keshavgupta21/6.115-final/PSoCCreator/Final Project/ComponentUpdateLog.txt

Last Modified Date & Time: 05/02/2019 18:38:56
