keshavgupta21/6.115-final/Final Report/debounce_fsm.png

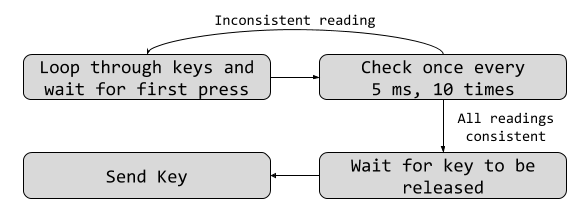
Final Report/debounce_fsm.png
