keshavgupta21/6.115-final/Final Report/spi_datasheet.png

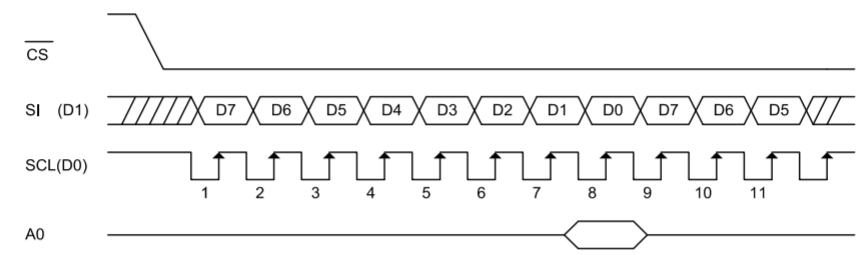
Final Report/spi_datasheet.png
