keshavgupta21/6.115-final/Proposal Draft/hardware.png

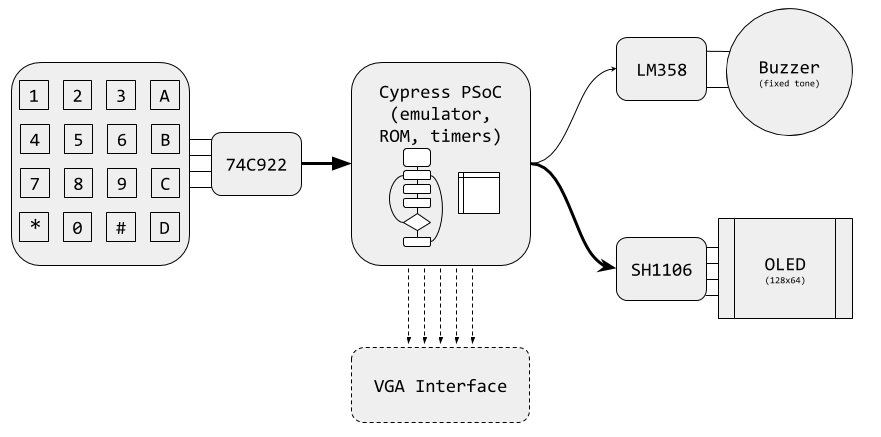
Proposal Draft/hardware.png
