keshavgupta21/6.115-final/Proposal Draft/software.png

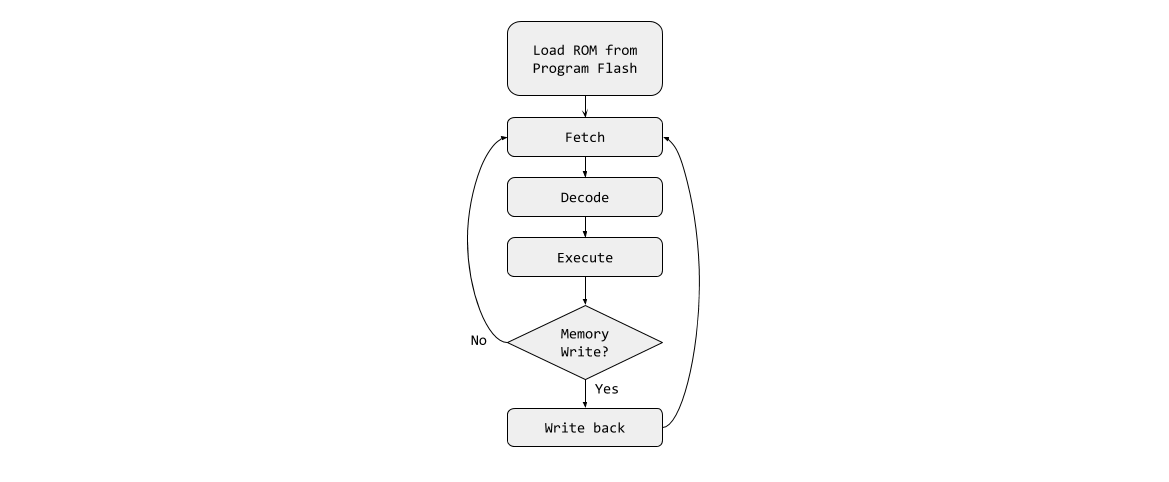
Proposal Draft/software.png
