keshavgupta21/6.115-final/(list of files, cad)

Other CAD files:
case/box.dwg
