keshavgupta21/6.115-final/PSoCCreator/Final Project/FinalEmulator.cydsn/CortexM3/ARM_GCC_541/Debug/LINK_options.txt

-Wl,--start-group -o "C:\\Users\\info\\Desktop\\Spring\ 2019\ Classes\\6.115\\6.115-final\\PSoCCreator\\Final\ Project\\FinalEmulator.cydsn\\CortexM3\\ARM_GCC_541\\Debug\\FinalEmulator.elf" ".\\CortexM3\\ARM_GCC_541\\Debug\\u8g2_bitmap.o" ".\\CortexM3\\ARM_GCC_541\\Debug\\u8g2_box.o" ".\\CortexM3\\ARM_GCC_541\\Debug\\u8g2_buffer.o" ".\\CortexM3\\ARM_GCC_541\\Debug\\u8g2_circle.o" ".\\CortexM3\\ARM_GCC_541\\Debug\\u8g2_cleardisplay.o" ".\\CortexM3\\ARM_GCC_541\\Debug\\u8g2_d_memory.o" ".\\CortexM3\\ARM_GCC_541\\Debug\\u8g2_d_setup.o" ".\\CortexM3\\ARM_GCC_541\\Debug\\u8g2_font.o" ".\\CortexM3\\ARM_GCC_541\\Debug\\u8g2_fonts.o" ".\\CortexM3\\ARM_GCC_541\\Debug\\u8g2_hvline.o" ".\\CortexM3\\ARM_GCC_541\\Debug\\u8g2_input_value.o" ".\\CortexM3\\ARM_GCC_541\\Debug\\u8g2_intersection.o" ".\\CortexM3\\ARM_GCC_541\\Debug\\u8g2_kerning.o" ".\\CortexM3\\ARM_GCC_541\\Debug\\u8g2_line.o" ".\\CortexM3\\ARM_GCC_541\\Debug\\u8g2_ll_hvline.o" ".\\CortexM3\\ARM_GCC_541\\Debug\\u8g2_message.o" ".\\CortexM3\\ARM_GCC_541\\Debug\\u8g2_polygon.o" ".\\CortexM3\\ARM_GCC_541\\Debug\\u8g2_selection_list.o" ".\\CortexM3\\ARM_GCC_541\\Debug\\u8g2_setup.o" ".\\CortexM3\\ARM_GCC_541\\Debug\\u8log.o" ".\\CortexM3\\ARM_GCC_541\\Debug\\u8log_u8g2.o" ".\\CortexM3\\ARM_GCC_541\\Debug\\u8log_u8x8.o" ".\\CortexM3\\ARM_GCC_541\\Debug\\u8x8_8x8.o" ".\\CortexM3\\ARM_GCC_541\\Debug\\u8x8_byte.o" ".\\CortexM3\\ARM_GCC_541\\Debug\\u8x8_cad.o" ".\\CortexM3\\ARM_GCC_541\\Debug\\u8x8_d_a2printer.o" ".\\CortexM3\\ARM_GCC_541\\Debug\\u8x8_d_il3820_296x128.o" ".\\CortexM3\\ARM_GCC_541\\Debug\\u8x8_d_ist3020.o" ".\\CortexM3\\ARM_GCC_541\\Debug\\u8x8_d_ks0108.o" ".\\CortexM3\\ARM_GCC_541\\Debug\\u8x8_d_lc7981.o" ".\\CortexM3\\ARM_GCC_541\\Debug\\u8x8_d_ld7032_60x32.o" ".\\CortexM3\\ARM_GCC_541\\Debug\\u8x8_d_ls013b7dh03.o" ".\\CortexM3\\ARM_GCC_541\\Debug\\u8x8_d_max7219.o" ".\\CortexM3\\ARM_GCC_541\\Debug\\u8x8_d_pcd8544_84x48.o" ".\\CortexM3\\ARM_GCC_541\\Debug\\u8x8_d_pcf8812.o" ".\\CortexM3\\ARM_GCC_541\\Debug\\u8x8_d_pcf8814_hx1230.o" ".\\CortexM3\\ARM_GCC_541\\Debug\\u8x8_d_sbn1661.o" ".\\CortexM3\\ARM_GCC_541\\Debug\\u8x8_d_sed1330.o" ".\\CortexM3\\ARM_GCC_541\\Debug\\u8x8_d_sh1106_64x32.o" ".\\CortexM3\\ARM_GCC_541\\Debug\\u8x8_d_sh1106_72x40.o" ".\\CortexM3\\ARM_GCC_541\\Debug\\u8x8_d_sh1107.o" ".\\CortexM3\\ARM_GCC_541\\Debug\\u8x8_d_sh1108.o" ".\\CortexM3\\ARM_GCC_541\\Debug\\u8x8_d_sh1122.o" ".\\CortexM3\\ARM_GCC_541\\Debug\\u8x8_d_ssd1305.o" ".\\CortexM3\\ARM_GCC_541\\Debug\\u8x8_d_ssd1306_48x64.o" ".\\CortexM3\\ARM_GCC_541\\Debug\\u8x8_d_ssd1306_64x32.o" ".\\CortexM3\\ARM_GCC_541\\Debug\\u8x8_d_ssd1306_64x48.o" ".\\CortexM3\\ARM_GCC_541\\Debug\\u8x8_d_ssd1306_96x16.o" ".\\CortexM3\\ARM_GCC_541\\Debug\\u8x8_d_ssd1306_128x32.o" ".\\CortexM3\\ARM_GCC_541\\Debug\\u8x8_d_ssd1306_128x64_noname.o" ".\\CortexM3\\ARM_GCC_541\\Debug\\u8x8_d_ssd1309.o" ".\\CortexM3\\ARM_GCC_541\\Debug\\u8x8_d_ssd1317.o" ".\\CortexM3\\ARM_GCC_541\\Debug\\u8x8_d_ssd1318.o" ".\\CortexM3\\ARM_GCC_541\\Debug\\u8x8_d_ssd1322.o" ".\\CortexM3\\ARM_GCC_541\\Debug\\u8x8_d_ssd1325.o" ".\\CortexM3\\ARM_GCC_541\\Debug\\u8x8_d_ssd1326.o" ".\\CortexM3\\ARM_GCC_541\\Debug\\u8x8_d_ssd1327.o" ".\\CortexM3\\ARM_GCC_541\\Debug\\u8x8_d_ssd1329.o" ".\\CortexM3\\ARM_GCC_541\\Debug\\u8x8_d_ssd1606_172x72.o" ".\\CortexM3\\ARM_GCC_541\\Debug\\u8x8_d_ssd1607_200x200.o" ".\\CortexM3\\ARM_GCC_541\\Debug\\u8x8_d_st7511.o" ".\\CortexM3\\ARM_GCC_541\\Debug\\u8x8_d_st7565.o" ".\\CortexM3\\ARM_GCC_541\\Debug\\u8x8_d_st7567.o" ".\\CortexM3\\ARM_GCC_541\\Debug\\u8x8_d_st7586s_erc240160.o" ".\\CortexM3\\ARM_GCC_541\\Debug\\u8x8_d_st7586s_s028hn118a.o" ".\\CortexM3\\ARM_GCC_541\\Debug\\u8x8_d_st7588.o" ".\\CortexM3\\ARM_GCC_541\\Debug\\u8x8_d_st7920.o" ".\\CortexM3\\ARM_GCC_541\\Debug\\u8x8_d_st75256.o" ".\\CortexM3\\ARM_GCC_541\\Debug\\u8x8_d_stdio.o" ".\\CortexM3\\ARM_GCC_541\\Debug\\u8x8_d_t6963.o" ".\\CortexM3\\ARM_GCC_541\\Debug\\u8x8_d_uc1601.o" ".\\CortexM3\\ARM_GCC_541\\Debug\\u8x8_d_uc1604.o" ".\\CortexM3\\ARM_GCC_541\\Debug\\u8x8_d_uc1608.o" ".\\CortexM3\\ARM_GCC_541\\Debug\\u8x8_d_uc1610.o" ".\\CortexM3\\ARM_GCC_541\\Debug\\u8x8_d_uc1611.o" ".\\CortexM3\\ARM_GCC_541\\Debug\\u8x8_d_uc1617.o" ".\\CortexM3\\ARM_GCC_541\\Debug\\u8x8_d_uc1638.o" ".\\CortexM3\\ARM_GCC_541\\Debug\\u8x8_d_uc1701_dogs102.o" ".\\CortexM3\\ARM_GCC_541\\Debug\\u8x8_d_uc1701_mini12864.o" ".\\CortexM3\\ARM_GCC_541\\Debug\\u8x8_debounce.o" ".\\CortexM3\\ARM_GCC_541\\Debug\\u8x8_display.o" ".\\CortexM3\\ARM_GCC_541\\Debug\\u8x8_fonts.o" ".\\CortexM3\\ARM_GCC_541\\Debug\\u8x8_gpio.o" ".\\CortexM3\\ARM_GCC_541\\Debug\\u8x8_input_value.o" ".\\CortexM3\\ARM_GCC_541\\Debug\\u8x8_message.o" ".\\CortexM3\\ARM_GCC_541\\Debug\\u8x8_selection_list.o" ".\\CortexM3\\ARM_GCC_541\\Debug\\u8x8_setup.o" ".\\CortexM3\\ARM_GCC_541\\Debug\\u8x8_string.o" ".\\CortexM3\\ARM_GCC_541\\Debug\\u8x8_u8toa.o" ".\\CortexM3\\ARM_GCC_541\\Debug\\u8x8_u16toa.o" ".\\CortexM3\\ARM_GCC_541\\Debug\\main.o" ".\\CortexM3\\ARM_GCC_541\\Debug\\procr.o" ".\\CortexM3\\ARM_GCC_541\\Debug\\video.o" ".\\CortexM3\\ARM_GCC_541\\Debug\\timer.o" ".\\CortexM3\\ARM_GCC_541\\Debug\\keybd.o" ".\\CortexM3\\ARM_GCC_541\\Debug\\oled.o" ".\\CortexM3\\ARM_GCC_541\\Debug\\uart.o" ".\\CortexM3\\ARM_GCC_541\\Debug\\cyfitter_cfg.o" ".\\CortexM3\\ARM_GCC_541\\Debug\\cymetadata.o" ".\\CortexM3\\ARM_GCC_541\\Debug\\Cm3Start.o" ".\\CortexM3\\ARM_GCC_541\\Debug\\FinalEmulator.a" "C:\\Program\ Files\ (x86)\\Cypress\\PSoC\ Creator\\4.2\\PSoC\ Creator\\psoc\\content\\cycomponentlibrary\\CyComponentLibrary.cylib\\CortexM3\\ARM_GCC_541\\Debug\\CyComponentLibrary.a" -mcpu=cortex-m3 -mthumb -L "Generated_Source\\PSoC5" "-Wl,-Map,.\\CortexM3\\ARM_GCC_541\\Debug/FinalEmulator.map" -T ".\\custom.ld" -specs=nano.specs -Wl,--gc-sections -g -ffunction-sections -Og -flto -ffat-lto-objects -Wl,--end-group
