keshavgupta21/6.115-final/PSoCCreator/Final Project/FinalEmulator.cydsn/codegentemp/pin_oled_dc.h

/*******************************************************************************
* File Name: pin_oled_dc.h  
* Version 2.20
*
* Description:
*  This file contains Pin function prototypes and register defines
*
* Note:
*
********************************************************************************
* Copyright 2008-2015, Cypress Semiconductor Corporation.  All rights reserved.
* You may use this file only in accordance with the license, terms, conditions, 
* disclaimers, and limitations in the end user license agreement accompanying 
* the software package with which this file was provided.
*******************************************************************************/

#if !defined(CY_PINS_pin_oled_dc_H) /* Pins pin_oled_dc_H */
#define CY_PINS_pin_oled_dc_H

#include "cytypes.h"
#include "cyfitter.h"
#include "cypins.h"
#include "pin_oled_dc_aliases.h"

/* APIs are not generated for P15[7:6] */
#if !(CY_PSOC5A &&\
	 pin_oled_dc__PORT == 15 && ((pin_oled_dc__MASK & 0xC0) != 0))


/***************************************
*        Function Prototypes             
***************************************/    

/**
* \addtogroup group_general
* @{
*/
void    pin_oled_dc_Write(uint8 value);
void    pin_oled_dc_SetDriveMode(uint8 mode);
uint8   pin_oled_dc_ReadDataReg(void);
uint8   pin_oled_dc_Read(void);
void    pin_oled_dc_SetInterruptMode(uint16 position, uint16 mode);
uint8   pin_oled_dc_ClearInterrupt(void);
/** @} general */

/***************************************
*           API Constants        
***************************************/
/**
* \addtogroup group_constants
* @{
*/
    /** \addtogroup driveMode Drive mode constants
     * \brief Constants to be passed as "mode" parameter in the pin_oled_dc_SetDriveMode() function.
     *  @{
     */
        #define pin_oled_dc_DM_ALG_HIZ         PIN_DM_ALG_HIZ
        #define pin_oled_dc_DM_DIG_HIZ         PIN_DM_DIG_HIZ
        #define pin_oled_dc_DM_RES_UP          PIN_DM_RES_UP
        #define pin_oled_dc_DM_RES_DWN         PIN_DM_RES_DWN
        #define pin_oled_dc_DM_OD_LO           PIN_DM_OD_LO
        #define pin_oled_dc_DM_OD_HI           PIN_DM_OD_HI
        #define pin_oled_dc_DM_STRONG          PIN_DM_STRONG
        #define pin_oled_dc_DM_RES_UPDWN       PIN_DM_RES_UPDWN
    /** @} driveMode */
/** @} group_constants */
    
/* Digital Port Constants */
#define pin_oled_dc_MASK               pin_oled_dc__MASK
#define pin_oled_dc_SHIFT              pin_oled_dc__SHIFT
#define pin_oled_dc_WIDTH              1u

/* Interrupt constants */
#if defined(pin_oled_dc__INTSTAT)
/**
* \addtogroup group_constants
* @{
*/
    /** \addtogroup intrMode Interrupt constants
     * \brief Constants to be passed as "mode" parameter in pin_oled_dc_SetInterruptMode() function.
     *  @{
     */
        #define pin_oled_dc_INTR_NONE      (uint16)(0x0000u)
        #define pin_oled_dc_INTR_RISING    (uint16)(0x0001u)
        #define pin_oled_dc_INTR_FALLING   (uint16)(0x0002u)
        #define pin_oled_dc_INTR_BOTH      (uint16)(0x0003u) 
    /** @} intrMode */
/** @} group_constants */

    #define pin_oled_dc_INTR_MASK      (0x01u) 
#endif /* (pin_oled_dc__INTSTAT) */


/***************************************
*             Registers        
***************************************/

/* Main Port Registers */
/* Pin State */
#define pin_oled_dc_PS                     (* (reg8 *) pin_oled_dc__PS)
/* Data Register */
#define pin_oled_dc_DR                     (* (reg8 *) pin_oled_dc__DR)
/* Port Number */
#define pin_oled_dc_PRT_NUM                (* (reg8 *) pin_oled_dc__PRT) 
/* Connect to Analog Globals */                                                  
#define pin_oled_dc_AG                     (* (reg8 *) pin_oled_dc__AG)                       
/* Analog MUX bux enable */
#define pin_oled_dc_AMUX                   (* (reg8 *) pin_oled_dc__AMUX) 
/* Bidirectional Enable */                                                        
#define pin_oled_dc_BIE                    (* (reg8 *) pin_oled_dc__BIE)
/* Bit-mask for Aliased Register Access */
#define pin_oled_dc_BIT_MASK               (* (reg8 *) pin_oled_dc__BIT_MASK)
/* Bypass Enable */
#define pin_oled_dc_BYP                    (* (reg8 *) pin_oled_dc__BYP)
/* Port wide control signals */                                                   
#define pin_oled_dc_CTL                    (* (reg8 *) pin_oled_dc__CTL)
/* Drive Modes */
#define pin_oled_dc_DM0                    (* (reg8 *) pin_oled_dc__DM0) 
#define pin_oled_dc_DM1                    (* (reg8 *) pin_oled_dc__DM1)
#define pin_oled_dc_DM2                    (* (reg8 *) pin_oled_dc__DM2) 
/* Input Buffer Disable Override */
#define pin_oled_dc_INP_DIS                (* (reg8 *) pin_oled_dc__INP_DIS)
/* LCD Common or Segment Drive */
#define pin_oled_dc_LCD_COM_SEG            (* (reg8 *) pin_oled_dc__LCD_COM_SEG)
/* Enable Segment LCD */
#define pin_oled_dc_LCD_EN                 (* (reg8 *) pin_oled_dc__LCD_EN)
/* Slew Rate Control */
#define pin_oled_dc_SLW                    (* (reg8 *) pin_oled_dc__SLW)

/* DSI Port Registers */
/* Global DSI Select Register */
#define pin_oled_dc_PRTDSI__CAPS_SEL       (* (reg8 *) pin_oled_dc__PRTDSI__CAPS_SEL) 
/* Double Sync Enable */
#define pin_oled_dc_PRTDSI__DBL_SYNC_IN    (* (reg8 *) pin_oled_dc__PRTDSI__DBL_SYNC_IN) 
/* Output Enable Select Drive Strength */
#define pin_oled_dc_PRTDSI__OE_SEL0        (* (reg8 *) pin_oled_dc__PRTDSI__OE_SEL0) 
#define pin_oled_dc_PRTDSI__OE_SEL1        (* (reg8 *) pin_oled_dc__PRTDSI__OE_SEL1) 
/* Port Pin Output Select Registers */
#define pin_oled_dc_PRTDSI__OUT_SEL0       (* (reg8 *) pin_oled_dc__PRTDSI__OUT_SEL0) 
#define pin_oled_dc_PRTDSI__OUT_SEL1       (* (reg8 *) pin_oled_dc__PRTDSI__OUT_SEL1) 
/* Sync Output Enable Registers */
#define pin_oled_dc_PRTDSI__SYNC_OUT       (* (reg8 *) pin_oled_dc__PRTDSI__SYNC_OUT) 

/* SIO registers */
#if defined(pin_oled_dc__SIO_CFG)
    #define pin_oled_dc_SIO_HYST_EN        (* (reg8 *) pin_oled_dc__SIO_HYST_EN)
    #define pin_oled_dc_SIO_REG_HIFREQ     (* (reg8 *) pin_oled_dc__SIO_REG_HIFREQ)
    #define pin_oled_dc_SIO_CFG            (* (reg8 *) pin_oled_dc__SIO_CFG)
    #define pin_oled_dc_SIO_DIFF           (* (reg8 *) pin_oled_dc__SIO_DIFF)
#endif /* (pin_oled_dc__SIO_CFG) */

/* Interrupt Registers */
#if defined(pin_oled_dc__INTSTAT)
    #define pin_oled_dc_INTSTAT            (* (reg8 *) pin_oled_dc__INTSTAT)
    #define pin_oled_dc_SNAP               (* (reg8 *) pin_oled_dc__SNAP)
    
	#define pin_oled_dc_0_INTTYPE_REG 		(* (reg8 *) pin_oled_dc__0__INTTYPE)
#endif /* (pin_oled_dc__INTSTAT) */

#endif /* CY_PSOC5A... */

#endif /*  CY_PINS_pin_oled_dc_H */


/* [] END OF FILE */
