keshavgupta21/6.115-final/PSoCCreator/Final Project/FinalEmulator.cydsn/codegentemp/pwm_snd.h

/*******************************************************************************
* File Name: pwm_snd.h
* Version 3.30
*
* Description:
*  Contains the prototypes and constants for the functions available to the
*  PWM user module.
*
* Note:
*
********************************************************************************
* Copyright 2008-2014, Cypress Semiconductor Corporation.  All rights reserved.
* You may use this file only in accordance with the license, terms, conditions,
* disclaimers, and limitations in the end user license agreement accompanying
* the software package with which this file was provided.
********************************************************************************/

#if !defined(CY_PWM_pwm_snd_H)
#define CY_PWM_pwm_snd_H

#include "cyfitter.h"
#include "cytypes.h"
#include "CyLib.h" /* For CyEnterCriticalSection() and CyExitCriticalSection() functions */

extern uint8 pwm_snd_initVar;


/***************************************
* Conditional Compilation Parameters
***************************************/
#define pwm_snd_Resolution                     (8u)
#define pwm_snd_UsingFixedFunction             (0u)
#define pwm_snd_DeadBandMode                   (0u)
#define pwm_snd_KillModeMinTime                (0u)
#define pwm_snd_KillMode                       (0u)
#define pwm_snd_PWMMode                        (0u)
#define pwm_snd_PWMModeIsCenterAligned         (0u)
#define pwm_snd_DeadBandUsed                   (0u)
#define pwm_snd_DeadBand2_4                    (0u)

#if !defined(pwm_snd_PWMUDB_genblk8_stsreg__REMOVED)
    #define pwm_snd_UseStatus                  (1u)
#else
    #define pwm_snd_UseStatus                  (0u)
#endif /* !defined(pwm_snd_PWMUDB_genblk8_stsreg__REMOVED) */

#if !defined(pwm_snd_PWMUDB_genblk1_ctrlreg__REMOVED)
    #define pwm_snd_UseControl                 (1u)
#else
    #define pwm_snd_UseControl                 (0u)
#endif /* !defined(pwm_snd_PWMUDB_genblk1_ctrlreg__REMOVED) */

#define pwm_snd_UseOneCompareMode              (1u)
#define pwm_snd_MinimumKillTime                (1u)
#define pwm_snd_EnableMode                     (0u)

#define pwm_snd_CompareMode1SW                 (0u)
#define pwm_snd_CompareMode2SW                 (0u)

/* Check to see if required defines such as CY_PSOC5LP are available */
/* They are defined starting with cy_boot v3.0 */
#if !defined (CY_PSOC5LP)
    #error Component PWM_v3_30 requires cy_boot v3.0 or later
#endif /* (CY_ PSOC5LP) */

/* Use Kill Mode Enumerated Types */
#define pwm_snd__B_PWM__DISABLED 0
#define pwm_snd__B_PWM__ASYNCHRONOUS 1
#define pwm_snd__B_PWM__SINGLECYCLE 2
#define pwm_snd__B_PWM__LATCHED 3
#define pwm_snd__B_PWM__MINTIME 4


/* Use Dead Band Mode Enumerated Types */
#define pwm_snd__B_PWM__DBMDISABLED 0
#define pwm_snd__B_PWM__DBM_2_4_CLOCKS 1
#define pwm_snd__B_PWM__DBM_256_CLOCKS 2


/* Used PWM Mode Enumerated Types */
#define pwm_snd__B_PWM__ONE_OUTPUT 0
#define pwm_snd__B_PWM__TWO_OUTPUTS 1
#define pwm_snd__B_PWM__DUAL_EDGE 2
#define pwm_snd__B_PWM__CENTER_ALIGN 3
#define pwm_snd__B_PWM__DITHER 5
#define pwm_snd__B_PWM__HARDWARESELECT 4


/* Used PWM Compare Mode Enumerated Types */
#define pwm_snd__B_PWM__LESS_THAN 1
#define pwm_snd__B_PWM__LESS_THAN_OR_EQUAL 2
#define pwm_snd__B_PWM__GREATER_THAN 3
#define pwm_snd__B_PWM__GREATER_THAN_OR_EQUAL_TO 4
#define pwm_snd__B_PWM__EQUAL 0
#define pwm_snd__B_PWM__FIRMWARE 5



/***************************************
* Data Struct Definition
***************************************/


/**************************************************************************
 * Sleep Wakeup Backup structure for PWM Component
 *************************************************************************/
typedef struct
{

    uint8 PWMEnableState;

    #if(!pwm_snd_UsingFixedFunction)
        uint8 PWMUdb;               /* PWM Current Counter value  */
        #if(!pwm_snd_PWMModeIsCenterAligned)
            uint8 PWMPeriod;
        #endif /* (!pwm_snd_PWMModeIsCenterAligned) */
        #if (pwm_snd_UseStatus)
            uint8 InterruptMaskValue;   /* PWM Current Interrupt Mask */
        #endif /* (pwm_snd_UseStatus) */

        /* Backup for Deadband parameters */
        #if(pwm_snd_DeadBandMode == pwm_snd__B_PWM__DBM_256_CLOCKS || \
            pwm_snd_DeadBandMode == pwm_snd__B_PWM__DBM_2_4_CLOCKS)
            uint8 PWMdeadBandValue; /* Dead Band Counter Current Value */
        #endif /* deadband count is either 2-4 clocks or 256 clocks */

        /* Backup Kill Mode Counter*/
        #if(pwm_snd_KillModeMinTime)
            uint8 PWMKillCounterPeriod; /* Kill Mode period value */
        #endif /* (pwm_snd_KillModeMinTime) */

        /* Backup control register */
        #if(pwm_snd_UseControl)
            uint8 PWMControlRegister; /* PWM Control Register value */
        #endif /* (pwm_snd_UseControl) */

    #endif /* (!pwm_snd_UsingFixedFunction) */

}pwm_snd_backupStruct;


/***************************************
*        Function Prototypes
 **************************************/

void    pwm_snd_Start(void) ;
void    pwm_snd_Stop(void) ;

#if (pwm_snd_UseStatus || pwm_snd_UsingFixedFunction)
    void  pwm_snd_SetInterruptMode(uint8 interruptMode) ;
    uint8 pwm_snd_ReadStatusRegister(void) ;
#endif /* (pwm_snd_UseStatus || pwm_snd_UsingFixedFunction) */

#define pwm_snd_GetInterruptSource() pwm_snd_ReadStatusRegister()

#if (pwm_snd_UseControl)
    uint8 pwm_snd_ReadControlRegister(void) ;
    void  pwm_snd_WriteControlRegister(uint8 control)
          ;
#endif /* (pwm_snd_UseControl) */

#if (pwm_snd_UseOneCompareMode)
   #if (pwm_snd_CompareMode1SW)
       void    pwm_snd_SetCompareMode(uint8 comparemode)
               ;
   #endif /* (pwm_snd_CompareMode1SW) */
#else
    #if (pwm_snd_CompareMode1SW)
        void    pwm_snd_SetCompareMode1(uint8 comparemode)
                ;
    #endif /* (pwm_snd_CompareMode1SW) */
    #if (pwm_snd_CompareMode2SW)
        void    pwm_snd_SetCompareMode2(uint8 comparemode)
                ;
    #endif /* (pwm_snd_CompareMode2SW) */
#endif /* (pwm_snd_UseOneCompareMode) */

#if (!pwm_snd_UsingFixedFunction)
    uint8   pwm_snd_ReadCounter(void) ;
    uint8 pwm_snd_ReadCapture(void) ;

    #if (pwm_snd_UseStatus)
            void pwm_snd_ClearFIFO(void) ;
    #endif /* (pwm_snd_UseStatus) */

    void    pwm_snd_WriteCounter(uint8 counter)
            ;
#endif /* (!pwm_snd_UsingFixedFunction) */

void    pwm_snd_WritePeriod(uint8 period)
        ;
uint8 pwm_snd_ReadPeriod(void) ;

#if (pwm_snd_UseOneCompareMode)
    void    pwm_snd_WriteCompare(uint8 compare)
            ;
    uint8 pwm_snd_ReadCompare(void) ;
#else
    void    pwm_snd_WriteCompare1(uint8 compare)
            ;
    uint8 pwm_snd_ReadCompare1(void) ;
    void    pwm_snd_WriteCompare2(uint8 compare)
            ;
    uint8 pwm_snd_ReadCompare2(void) ;
#endif /* (pwm_snd_UseOneCompareMode) */


#if (pwm_snd_DeadBandUsed)
    void    pwm_snd_WriteDeadTime(uint8 deadtime) ;
    uint8   pwm_snd_ReadDeadTime(void) ;
#endif /* (pwm_snd_DeadBandUsed) */

#if ( pwm_snd_KillModeMinTime)
    void pwm_snd_WriteKillTime(uint8 killtime) ;
    uint8 pwm_snd_ReadKillTime(void) ;
#endif /* ( pwm_snd_KillModeMinTime) */

void pwm_snd_Init(void) ;
void pwm_snd_Enable(void) ;
void pwm_snd_Sleep(void) ;
void pwm_snd_Wakeup(void) ;
void pwm_snd_SaveConfig(void) ;
void pwm_snd_RestoreConfig(void) ;


/***************************************
*         Initialization Values
**************************************/
#define pwm_snd_INIT_PERIOD_VALUE          (1u)
#define pwm_snd_INIT_COMPARE_VALUE1        (0u)
#define pwm_snd_INIT_COMPARE_VALUE2        (128u)
#define pwm_snd_INIT_INTERRUPTS_MODE       (uint8)(((uint8)(0u <<   \
                                                    pwm_snd_STATUS_TC_INT_EN_MASK_SHIFT)) | \
                                                    (uint8)((uint8)(0u <<  \
                                                    pwm_snd_STATUS_CMP2_INT_EN_MASK_SHIFT)) | \
                                                    (uint8)((uint8)(0u <<  \
                                                    pwm_snd_STATUS_CMP1_INT_EN_MASK_SHIFT )) | \
                                                    (uint8)((uint8)(0u <<  \
                                                    pwm_snd_STATUS_KILL_INT_EN_MASK_SHIFT )))
#define pwm_snd_DEFAULT_COMPARE2_MODE      (uint8)((uint8)2u <<  pwm_snd_CTRL_CMPMODE2_SHIFT)
#define pwm_snd_DEFAULT_COMPARE1_MODE      (uint8)((uint8)2u <<  pwm_snd_CTRL_CMPMODE1_SHIFT)
#define pwm_snd_INIT_DEAD_TIME             (1u)


/********************************
*         Registers
******************************** */

#if (pwm_snd_UsingFixedFunction)
   #define pwm_snd_PERIOD_LSB              (*(reg16 *) pwm_snd_PWMHW__PER0)
   #define pwm_snd_PERIOD_LSB_PTR          ( (reg16 *) pwm_snd_PWMHW__PER0)
   #define pwm_snd_COMPARE1_LSB            (*(reg16 *) pwm_snd_PWMHW__CNT_CMP0)
   #define pwm_snd_COMPARE1_LSB_PTR        ( (reg16 *) pwm_snd_PWMHW__CNT_CMP0)
   #define pwm_snd_COMPARE2_LSB            (0x00u)
   #define pwm_snd_COMPARE2_LSB_PTR        (0x00u)
   #define pwm_snd_COUNTER_LSB             (*(reg16 *) pwm_snd_PWMHW__CNT_CMP0)
   #define pwm_snd_COUNTER_LSB_PTR         ( (reg16 *) pwm_snd_PWMHW__CNT_CMP0)
   #define pwm_snd_CAPTURE_LSB             (*(reg16 *) pwm_snd_PWMHW__CAP0)
   #define pwm_snd_CAPTURE_LSB_PTR         ( (reg16 *) pwm_snd_PWMHW__CAP0)
   #define pwm_snd_RT1                     (*(reg8 *)  pwm_snd_PWMHW__RT1)
   #define pwm_snd_RT1_PTR                 ( (reg8 *)  pwm_snd_PWMHW__RT1)

#else
   #if (pwm_snd_Resolution == 8u) /* 8bit - PWM */

       #if(pwm_snd_PWMModeIsCenterAligned)
           #define pwm_snd_PERIOD_LSB      (*(reg8 *)  pwm_snd_PWMUDB_sP8_pwmdp_u0__D1_REG)
           #define pwm_snd_PERIOD_LSB_PTR  ((reg8 *)   pwm_snd_PWMUDB_sP8_pwmdp_u0__D1_REG)
       #else
           #define pwm_snd_PERIOD_LSB      (*(reg8 *)  pwm_snd_PWMUDB_sP8_pwmdp_u0__F0_REG)
           #define pwm_snd_PERIOD_LSB_PTR  ((reg8 *)   pwm_snd_PWMUDB_sP8_pwmdp_u0__F0_REG)
       #endif /* (pwm_snd_PWMModeIsCenterAligned) */

       #define pwm_snd_COMPARE1_LSB        (*(reg8 *)  pwm_snd_PWMUDB_sP8_pwmdp_u0__D0_REG)
       #define pwm_snd_COMPARE1_LSB_PTR    ((reg8 *)   pwm_snd_PWMUDB_sP8_pwmdp_u0__D0_REG)
       #define pwm_snd_COMPARE2_LSB        (*(reg8 *)  pwm_snd_PWMUDB_sP8_pwmdp_u0__D1_REG)
       #define pwm_snd_COMPARE2_LSB_PTR    ((reg8 *)   pwm_snd_PWMUDB_sP8_pwmdp_u0__D1_REG)
       #define pwm_snd_COUNTERCAP_LSB      (*(reg8 *)  pwm_snd_PWMUDB_sP8_pwmdp_u0__A1_REG)
       #define pwm_snd_COUNTERCAP_LSB_PTR  ((reg8 *)   pwm_snd_PWMUDB_sP8_pwmdp_u0__A1_REG)
       #define pwm_snd_COUNTER_LSB         (*(reg8 *)  pwm_snd_PWMUDB_sP8_pwmdp_u0__A0_REG)
       #define pwm_snd_COUNTER_LSB_PTR     ((reg8 *)   pwm_snd_PWMUDB_sP8_pwmdp_u0__A0_REG)
       #define pwm_snd_CAPTURE_LSB         (*(reg8 *)  pwm_snd_PWMUDB_sP8_pwmdp_u0__F1_REG)
       #define pwm_snd_CAPTURE_LSB_PTR     ((reg8 *)   pwm_snd_PWMUDB_sP8_pwmdp_u0__F1_REG)

   #else
        #if(CY_PSOC3) /* 8-bit address space */
            #if(pwm_snd_PWMModeIsCenterAligned)
               #define pwm_snd_PERIOD_LSB      (*(reg16 *) pwm_snd_PWMUDB_sP8_pwmdp_u0__D1_REG)
               #define pwm_snd_PERIOD_LSB_PTR  ((reg16 *)  pwm_snd_PWMUDB_sP8_pwmdp_u0__D1_REG)
            #else
               #define pwm_snd_PERIOD_LSB      (*(reg16 *) pwm_snd_PWMUDB_sP8_pwmdp_u0__F0_REG)
               #define pwm_snd_PERIOD_LSB_PTR  ((reg16 *)  pwm_snd_PWMUDB_sP8_pwmdp_u0__F0_REG)
            #endif /* (pwm_snd_PWMModeIsCenterAligned) */

            #define pwm_snd_COMPARE1_LSB       (*(reg16 *) pwm_snd_PWMUDB_sP8_pwmdp_u0__D0_REG)
            #define pwm_snd_COMPARE1_LSB_PTR   ((reg16 *)  pwm_snd_PWMUDB_sP8_pwmdp_u0__D0_REG)
            #define pwm_snd_COMPARE2_LSB       (*(reg16 *) pwm_snd_PWMUDB_sP8_pwmdp_u0__D1_REG)
            #define pwm_snd_COMPARE2_LSB_PTR   ((reg16 *)  pwm_snd_PWMUDB_sP8_pwmdp_u0__D1_REG)
            #define pwm_snd_COUNTERCAP_LSB     (*(reg16 *) pwm_snd_PWMUDB_sP8_pwmdp_u0__A1_REG)
            #define pwm_snd_COUNTERCAP_LSB_PTR ((reg16 *)  pwm_snd_PWMUDB_sP8_pwmdp_u0__A1_REG)
            #define pwm_snd_COUNTER_LSB        (*(reg16 *) pwm_snd_PWMUDB_sP8_pwmdp_u0__A0_REG)
            #define pwm_snd_COUNTER_LSB_PTR    ((reg16 *)  pwm_snd_PWMUDB_sP8_pwmdp_u0__A0_REG)
            #define pwm_snd_CAPTURE_LSB        (*(reg16 *) pwm_snd_PWMUDB_sP8_pwmdp_u0__F1_REG)
            #define pwm_snd_CAPTURE_LSB_PTR    ((reg16 *)  pwm_snd_PWMUDB_sP8_pwmdp_u0__F1_REG)
        #else
            #if(pwm_snd_PWMModeIsCenterAligned)
               #define pwm_snd_PERIOD_LSB      (*(reg16 *) pwm_snd_PWMUDB_sP8_pwmdp_u0__16BIT_D1_REG)
               #define pwm_snd_PERIOD_LSB_PTR  ((reg16 *)  pwm_snd_PWMUDB_sP8_pwmdp_u0__16BIT_D1_REG)
            #else
               #define pwm_snd_PERIOD_LSB      (*(reg16 *) pwm_snd_PWMUDB_sP8_pwmdp_u0__16BIT_F0_REG)
               #define pwm_snd_PERIOD_LSB_PTR  ((reg16 *)  pwm_snd_PWMUDB_sP8_pwmdp_u0__16BIT_F0_REG)
            #endif /* (pwm_snd_PWMModeIsCenterAligned) */

            #define pwm_snd_COMPARE1_LSB       (*(reg16 *) pwm_snd_PWMUDB_sP8_pwmdp_u0__16BIT_D0_REG)
            #define pwm_snd_COMPARE1_LSB_PTR   ((reg16 *)  pwm_snd_PWMUDB_sP8_pwmdp_u0__16BIT_D0_REG)
            #define pwm_snd_COMPARE2_LSB       (*(reg16 *) pwm_snd_PWMUDB_sP8_pwmdp_u0__16BIT_D1_REG)
            #define pwm_snd_COMPARE2_LSB_PTR   ((reg16 *)  pwm_snd_PWMUDB_sP8_pwmdp_u0__16BIT_D1_REG)
            #define pwm_snd_COUNTERCAP_LSB     (*(reg16 *) pwm_snd_PWMUDB_sP8_pwmdp_u0__16BIT_A1_REG)
            #define pwm_snd_COUNTERCAP_LSB_PTR ((reg16 *)  pwm_snd_PWMUDB_sP8_pwmdp_u0__16BIT_A1_REG)
            #define pwm_snd_COUNTER_LSB        (*(reg16 *) pwm_snd_PWMUDB_sP8_pwmdp_u0__16BIT_A0_REG)
            #define pwm_snd_COUNTER_LSB_PTR    ((reg16 *)  pwm_snd_PWMUDB_sP8_pwmdp_u0__16BIT_A0_REG)
            #define pwm_snd_CAPTURE_LSB        (*(reg16 *) pwm_snd_PWMUDB_sP8_pwmdp_u0__16BIT_F1_REG)
            #define pwm_snd_CAPTURE_LSB_PTR    ((reg16 *)  pwm_snd_PWMUDB_sP8_pwmdp_u0__16BIT_F1_REG)
        #endif /* (CY_PSOC3) */

       #define pwm_snd_AUX_CONTROLDP1          (*(reg8 *)  pwm_snd_PWMUDB_sP8_pwmdp_u1__DP_AUX_CTL_REG)
       #define pwm_snd_AUX_CONTROLDP1_PTR      ((reg8 *)   pwm_snd_PWMUDB_sP8_pwmdp_u1__DP_AUX_CTL_REG)

   #endif /* (pwm_snd_Resolution == 8) */

   #define pwm_snd_COUNTERCAP_LSB_PTR_8BIT ( (reg8 *)  pwm_snd_PWMUDB_sP8_pwmdp_u0__A1_REG)
   #define pwm_snd_AUX_CONTROLDP0          (*(reg8 *)  pwm_snd_PWMUDB_sP8_pwmdp_u0__DP_AUX_CTL_REG)
   #define pwm_snd_AUX_CONTROLDP0_PTR      ((reg8 *)   pwm_snd_PWMUDB_sP8_pwmdp_u0__DP_AUX_CTL_REG)

#endif /* (pwm_snd_UsingFixedFunction) */

#if(pwm_snd_KillModeMinTime )
    #define pwm_snd_KILLMODEMINTIME        (*(reg8 *)  pwm_snd_PWMUDB_sKM_killmodecounterdp_u0__D0_REG)
    #define pwm_snd_KILLMODEMINTIME_PTR    ((reg8 *)   pwm_snd_PWMUDB_sKM_killmodecounterdp_u0__D0_REG)
    /* Fixed Function Block has no Kill Mode parameters because it is Asynchronous only */
#endif /* (pwm_snd_KillModeMinTime ) */

#if(pwm_snd_DeadBandMode == pwm_snd__B_PWM__DBM_256_CLOCKS)
    #define pwm_snd_DEADBAND_COUNT         (*(reg8 *)  pwm_snd_PWMUDB_sDB255_deadbandcounterdp_u0__D0_REG)
    #define pwm_snd_DEADBAND_COUNT_PTR     ((reg8 *)   pwm_snd_PWMUDB_sDB255_deadbandcounterdp_u0__D0_REG)
    #define pwm_snd_DEADBAND_LSB_PTR       ((reg8 *)   pwm_snd_PWMUDB_sDB255_deadbandcounterdp_u0__A0_REG)
    #define pwm_snd_DEADBAND_LSB           (*(reg8 *)  pwm_snd_PWMUDB_sDB255_deadbandcounterdp_u0__A0_REG)
#elif(pwm_snd_DeadBandMode == pwm_snd__B_PWM__DBM_2_4_CLOCKS)
    
    /* In Fixed Function Block these bits are in the control blocks control register */
    #if (pwm_snd_UsingFixedFunction)
        #define pwm_snd_DEADBAND_COUNT         (*(reg8 *)  pwm_snd_PWMHW__CFG0)
        #define pwm_snd_DEADBAND_COUNT_PTR     ((reg8 *)   pwm_snd_PWMHW__CFG0)
        #define pwm_snd_DEADBAND_COUNT_MASK    (uint8)((uint8)0x03u << pwm_snd_DEADBAND_COUNT_SHIFT)

        /* As defined by the Register Map as DEADBAND_PERIOD[1:0] in CFG0 */
        #define pwm_snd_DEADBAND_COUNT_SHIFT   (0x06u)
    #else
        /* Lower two bits of the added control register define the count 1-3 */
        #define pwm_snd_DEADBAND_COUNT         (*(reg8 *)  pwm_snd_PWMUDB_genblk7_dbctrlreg__CONTROL_REG)
        #define pwm_snd_DEADBAND_COUNT_PTR     ((reg8 *)   pwm_snd_PWMUDB_genblk7_dbctrlreg__CONTROL_REG)
        #define pwm_snd_DEADBAND_COUNT_MASK    (uint8)((uint8)0x03u << pwm_snd_DEADBAND_COUNT_SHIFT)

        /* As defined by the verilog implementation of the Control Register */
        #define pwm_snd_DEADBAND_COUNT_SHIFT   (0x00u)
    #endif /* (pwm_snd_UsingFixedFunction) */
#endif /* (pwm_snd_DeadBandMode == pwm_snd__B_PWM__DBM_256_CLOCKS) */



#if (pwm_snd_UsingFixedFunction)
    #define pwm_snd_STATUS                 (*(reg8 *) pwm_snd_PWMHW__SR0)
    #define pwm_snd_STATUS_PTR             ((reg8 *) pwm_snd_PWMHW__SR0)
    #define pwm_snd_STATUS_MASK            (*(reg8 *) pwm_snd_PWMHW__SR0)
    #define pwm_snd_STATUS_MASK_PTR        ((reg8 *) pwm_snd_PWMHW__SR0)
    #define pwm_snd_CONTROL                (*(reg8 *) pwm_snd_PWMHW__CFG0)
    #define pwm_snd_CONTROL_PTR            ((reg8 *) pwm_snd_PWMHW__CFG0)
    #define pwm_snd_CONTROL2               (*(reg8 *) pwm_snd_PWMHW__CFG1)
    #define pwm_snd_CONTROL3               (*(reg8 *) pwm_snd_PWMHW__CFG2)
    #define pwm_snd_GLOBAL_ENABLE          (*(reg8 *) pwm_snd_PWMHW__PM_ACT_CFG)
    #define pwm_snd_GLOBAL_ENABLE_PTR      ( (reg8 *) pwm_snd_PWMHW__PM_ACT_CFG)
    #define pwm_snd_GLOBAL_STBY_ENABLE     (*(reg8 *) pwm_snd_PWMHW__PM_STBY_CFG)
    #define pwm_snd_GLOBAL_STBY_ENABLE_PTR ( (reg8 *) pwm_snd_PWMHW__PM_STBY_CFG)


    /***********************************
    *          Constants
    ***********************************/

    /* Fixed Function Block Chosen */
    #define pwm_snd_BLOCK_EN_MASK          (pwm_snd_PWMHW__PM_ACT_MSK)
    #define pwm_snd_BLOCK_STBY_EN_MASK     (pwm_snd_PWMHW__PM_STBY_MSK)
    
    /* Control Register definitions */
    #define pwm_snd_CTRL_ENABLE_SHIFT      (0x00u)

    /* As defined by Register map as MODE_CFG bits in CFG2*/
    #define pwm_snd_CTRL_CMPMODE1_SHIFT    (0x04u)

    /* As defined by Register map */
    #define pwm_snd_CTRL_DEAD_TIME_SHIFT   (0x06u)  

    /* Fixed Function Block Only CFG register bit definitions */
    /*  Set to compare mode */
    #define pwm_snd_CFG0_MODE              (0x02u)   

    /* Enable the block to run */
    #define pwm_snd_CFG0_ENABLE            (0x01u)   
    
    /* As defined by Register map as DB bit in CFG0 */
    #define pwm_snd_CFG0_DB                (0x20u)   

    /* Control Register Bit Masks */
    #define pwm_snd_CTRL_ENABLE            (uint8)((uint8)0x01u << pwm_snd_CTRL_ENABLE_SHIFT)
    #define pwm_snd_CTRL_RESET             (uint8)((uint8)0x01u << pwm_snd_CTRL_RESET_SHIFT)
    #define pwm_snd_CTRL_CMPMODE2_MASK     (uint8)((uint8)0x07u << pwm_snd_CTRL_CMPMODE2_SHIFT)
    #define pwm_snd_CTRL_CMPMODE1_MASK     (uint8)((uint8)0x07u << pwm_snd_CTRL_CMPMODE1_SHIFT)

    /* Control2 Register Bit Masks */
    /* As defined in Register Map, Part of the TMRX_CFG1 register */
    #define pwm_snd_CTRL2_IRQ_SEL_SHIFT    (0x00u)
    #define pwm_snd_CTRL2_IRQ_SEL          (uint8)((uint8)0x01u << pwm_snd_CTRL2_IRQ_SEL_SHIFT)

    /* Status Register Bit Locations */
    /* As defined by Register map as TC in SR0 */
    #define pwm_snd_STATUS_TC_SHIFT        (0x07u)   
    
    /* As defined by the Register map as CAP_CMP in SR0 */
    #define pwm_snd_STATUS_CMP1_SHIFT      (0x06u)   

    /* Status Register Interrupt Enable Bit Locations */
    #define pwm_snd_STATUS_KILL_INT_EN_MASK_SHIFT          (0x00u)
    #define pwm_snd_STATUS_TC_INT_EN_MASK_SHIFT            (pwm_snd_STATUS_TC_SHIFT - 4u)
    #define pwm_snd_STATUS_CMP2_INT_EN_MASK_SHIFT          (0x00u)
    #define pwm_snd_STATUS_CMP1_INT_EN_MASK_SHIFT          (pwm_snd_STATUS_CMP1_SHIFT - 4u)

    /* Status Register Bit Masks */
    #define pwm_snd_STATUS_TC              (uint8)((uint8)0x01u << pwm_snd_STATUS_TC_SHIFT)
    #define pwm_snd_STATUS_CMP1            (uint8)((uint8)0x01u << pwm_snd_STATUS_CMP1_SHIFT)

    /* Status Register Interrupt Bit Masks */
    #define pwm_snd_STATUS_TC_INT_EN_MASK              (uint8)((uint8)pwm_snd_STATUS_TC >> 4u)
    #define pwm_snd_STATUS_CMP1_INT_EN_MASK            (uint8)((uint8)pwm_snd_STATUS_CMP1 >> 4u)

    /*RT1 Synch Constants */
    #define pwm_snd_RT1_SHIFT             (0x04u)

    /* Sync TC and CMP bit masks */
    #define pwm_snd_RT1_MASK              (uint8)((uint8)0x03u << pwm_snd_RT1_SHIFT)
    #define pwm_snd_SYNC                  (uint8)((uint8)0x03u << pwm_snd_RT1_SHIFT)
    #define pwm_snd_SYNCDSI_SHIFT         (0x00u)

    /* Sync all DSI inputs */
    #define pwm_snd_SYNCDSI_MASK          (uint8)((uint8)0x0Fu << pwm_snd_SYNCDSI_SHIFT)

    /* Sync all DSI inputs */
    #define pwm_snd_SYNCDSI_EN            (uint8)((uint8)0x0Fu << pwm_snd_SYNCDSI_SHIFT)


#else
    #define pwm_snd_STATUS                (*(reg8 *)   pwm_snd_PWMUDB_genblk8_stsreg__STATUS_REG )
    #define pwm_snd_STATUS_PTR            ((reg8 *)    pwm_snd_PWMUDB_genblk8_stsreg__STATUS_REG )
    #define pwm_snd_STATUS_MASK           (*(reg8 *)   pwm_snd_PWMUDB_genblk8_stsreg__MASK_REG)
    #define pwm_snd_STATUS_MASK_PTR       ((reg8 *)    pwm_snd_PWMUDB_genblk8_stsreg__MASK_REG)
    #define pwm_snd_STATUS_AUX_CTRL       (*(reg8 *)   pwm_snd_PWMUDB_genblk8_stsreg__STATUS_AUX_CTL_REG)
    #define pwm_snd_CONTROL               (*(reg8 *)   pwm_snd_PWMUDB_genblk1_ctrlreg__CONTROL_REG)
    #define pwm_snd_CONTROL_PTR           ((reg8 *)    pwm_snd_PWMUDB_genblk1_ctrlreg__CONTROL_REG)


    /***********************************
    *          Constants
    ***********************************/

    /* Control Register bit definitions */
    #define pwm_snd_CTRL_ENABLE_SHIFT      (0x07u)
    #define pwm_snd_CTRL_RESET_SHIFT       (0x06u)
    #define pwm_snd_CTRL_CMPMODE2_SHIFT    (0x03u)
    #define pwm_snd_CTRL_CMPMODE1_SHIFT    (0x00u)
    #define pwm_snd_CTRL_DEAD_TIME_SHIFT   (0x00u)   /* No Shift Needed for UDB block */
    
    /* Control Register Bit Masks */
    #define pwm_snd_CTRL_ENABLE            (uint8)((uint8)0x01u << pwm_snd_CTRL_ENABLE_SHIFT)
    #define pwm_snd_CTRL_RESET             (uint8)((uint8)0x01u << pwm_snd_CTRL_RESET_SHIFT)
    #define pwm_snd_CTRL_CMPMODE2_MASK     (uint8)((uint8)0x07u << pwm_snd_CTRL_CMPMODE2_SHIFT)
    #define pwm_snd_CTRL_CMPMODE1_MASK     (uint8)((uint8)0x07u << pwm_snd_CTRL_CMPMODE1_SHIFT)

    /* Status Register Bit Locations */
    #define pwm_snd_STATUS_KILL_SHIFT          (0x05u)
    #define pwm_snd_STATUS_FIFONEMPTY_SHIFT    (0x04u)
    #define pwm_snd_STATUS_FIFOFULL_SHIFT      (0x03u)
    #define pwm_snd_STATUS_TC_SHIFT            (0x02u)
    #define pwm_snd_STATUS_CMP2_SHIFT          (0x01u)
    #define pwm_snd_STATUS_CMP1_SHIFT          (0x00u)

    /* Status Register Interrupt Enable Bit Locations - UDB Status Interrupt Mask match Status Bit Locations*/
    #define pwm_snd_STATUS_KILL_INT_EN_MASK_SHIFT          (pwm_snd_STATUS_KILL_SHIFT)
    #define pwm_snd_STATUS_FIFONEMPTY_INT_EN_MASK_SHIFT    (pwm_snd_STATUS_FIFONEMPTY_SHIFT)
    #define pwm_snd_STATUS_FIFOFULL_INT_EN_MASK_SHIFT      (pwm_snd_STATUS_FIFOFULL_SHIFT)
    #define pwm_snd_STATUS_TC_INT_EN_MASK_SHIFT            (pwm_snd_STATUS_TC_SHIFT)
    #define pwm_snd_STATUS_CMP2_INT_EN_MASK_SHIFT          (pwm_snd_STATUS_CMP2_SHIFT)
    #define pwm_snd_STATUS_CMP1_INT_EN_MASK_SHIFT          (pwm_snd_STATUS_CMP1_SHIFT)

    /* Status Register Bit Masks */
    #define pwm_snd_STATUS_KILL            (uint8)((uint8)0x00u << pwm_snd_STATUS_KILL_SHIFT )
    #define pwm_snd_STATUS_FIFOFULL        (uint8)((uint8)0x01u << pwm_snd_STATUS_FIFOFULL_SHIFT)
    #define pwm_snd_STATUS_FIFONEMPTY      (uint8)((uint8)0x01u << pwm_snd_STATUS_FIFONEMPTY_SHIFT)
    #define pwm_snd_STATUS_TC              (uint8)((uint8)0x01u << pwm_snd_STATUS_TC_SHIFT)
    #define pwm_snd_STATUS_CMP2            (uint8)((uint8)0x01u << pwm_snd_STATUS_CMP2_SHIFT)
    #define pwm_snd_STATUS_CMP1            (uint8)((uint8)0x01u << pwm_snd_STATUS_CMP1_SHIFT)

    /* Status Register Interrupt Bit Masks  - UDB Status Interrupt Mask match Status Bit Locations */
    #define pwm_snd_STATUS_KILL_INT_EN_MASK            (pwm_snd_STATUS_KILL)
    #define pwm_snd_STATUS_FIFOFULL_INT_EN_MASK        (pwm_snd_STATUS_FIFOFULL)
    #define pwm_snd_STATUS_FIFONEMPTY_INT_EN_MASK      (pwm_snd_STATUS_FIFONEMPTY)
    #define pwm_snd_STATUS_TC_INT_EN_MASK              (pwm_snd_STATUS_TC)
    #define pwm_snd_STATUS_CMP2_INT_EN_MASK            (pwm_snd_STATUS_CMP2)
    #define pwm_snd_STATUS_CMP1_INT_EN_MASK            (pwm_snd_STATUS_CMP1)

    /* Datapath Auxillary Control Register bit definitions */
    #define pwm_snd_AUX_CTRL_FIFO0_CLR         (0x01u)
    #define pwm_snd_AUX_CTRL_FIFO1_CLR         (0x02u)
    #define pwm_snd_AUX_CTRL_FIFO0_LVL         (0x04u)
    #define pwm_snd_AUX_CTRL_FIFO1_LVL         (0x08u)
    #define pwm_snd_STATUS_ACTL_INT_EN_MASK    (0x10u) /* As defined for the ACTL Register */
#endif /* pwm_snd_UsingFixedFunction */

#endif  /* CY_PWM_pwm_snd_H */


/* [] END OF FILE */
