keshavgupta21/6.115-final/PSoCCreator/Final Project/FinalEmulator.cydsn/codegentemp/spi_oled_IntClock.h

/*******************************************************************************
* File Name: spi_oled_IntClock.h
* Version 2.20
*
*  Description:
*   Provides the function and constant definitions for the clock component.
*
*  Note:
*
********************************************************************************
* Copyright 2008-2012, Cypress Semiconductor Corporation.  All rights reserved.
* You may use this file only in accordance with the license, terms, conditions, 
* disclaimers, and limitations in the end user license agreement accompanying 
* the software package with which this file was provided.
*******************************************************************************/

#if !defined(CY_CLOCK_spi_oled_IntClock_H)
#define CY_CLOCK_spi_oled_IntClock_H

#include <cytypes.h>
#include <cyfitter.h>


/***************************************
* Conditional Compilation Parameters
***************************************/

/* Check to see if required defines such as CY_PSOC5LP are available */
/* They are defined starting with cy_boot v3.0 */
#if !defined (CY_PSOC5LP)
    #error Component cy_clock_v2_20 requires cy_boot v3.0 or later
#endif /* (CY_PSOC5LP) */


/***************************************
*        Function Prototypes
***************************************/

void spi_oled_IntClock_Start(void) ;
void spi_oled_IntClock_Stop(void) ;

#if(CY_PSOC3 || CY_PSOC5LP)
void spi_oled_IntClock_StopBlock(void) ;
#endif /* (CY_PSOC3 || CY_PSOC5LP) */

void spi_oled_IntClock_StandbyPower(uint8 state) ;
void spi_oled_IntClock_SetDividerRegister(uint16 clkDivider, uint8 restart) 
                                ;
uint16 spi_oled_IntClock_GetDividerRegister(void) ;
void spi_oled_IntClock_SetModeRegister(uint8 modeBitMask) ;
void spi_oled_IntClock_ClearModeRegister(uint8 modeBitMask) ;
uint8 spi_oled_IntClock_GetModeRegister(void) ;
void spi_oled_IntClock_SetSourceRegister(uint8 clkSource) ;
uint8 spi_oled_IntClock_GetSourceRegister(void) ;
#if defined(spi_oled_IntClock__CFG3)
void spi_oled_IntClock_SetPhaseRegister(uint8 clkPhase) ;
uint8 spi_oled_IntClock_GetPhaseRegister(void) ;
#endif /* defined(spi_oled_IntClock__CFG3) */

#define spi_oled_IntClock_Enable()                       spi_oled_IntClock_Start()
#define spi_oled_IntClock_Disable()                      spi_oled_IntClock_Stop()
#define spi_oled_IntClock_SetDivider(clkDivider)         spi_oled_IntClock_SetDividerRegister(clkDivider, 1u)
#define spi_oled_IntClock_SetDividerValue(clkDivider)    spi_oled_IntClock_SetDividerRegister((clkDivider) - 1u, 1u)
#define spi_oled_IntClock_SetMode(clkMode)               spi_oled_IntClock_SetModeRegister(clkMode)
#define spi_oled_IntClock_SetSource(clkSource)           spi_oled_IntClock_SetSourceRegister(clkSource)
#if defined(spi_oled_IntClock__CFG3)
#define spi_oled_IntClock_SetPhase(clkPhase)             spi_oled_IntClock_SetPhaseRegister(clkPhase)
#define spi_oled_IntClock_SetPhaseValue(clkPhase)        spi_oled_IntClock_SetPhaseRegister((clkPhase) + 1u)
#endif /* defined(spi_oled_IntClock__CFG3) */


/***************************************
*             Registers
***************************************/

/* Register to enable or disable the clock */
#define spi_oled_IntClock_CLKEN              (* (reg8 *) spi_oled_IntClock__PM_ACT_CFG)
#define spi_oled_IntClock_CLKEN_PTR          ((reg8 *) spi_oled_IntClock__PM_ACT_CFG)

/* Register to enable or disable the clock */
#define spi_oled_IntClock_CLKSTBY            (* (reg8 *) spi_oled_IntClock__PM_STBY_CFG)
#define spi_oled_IntClock_CLKSTBY_PTR        ((reg8 *) spi_oled_IntClock__PM_STBY_CFG)

/* Clock LSB divider configuration register. */
#define spi_oled_IntClock_DIV_LSB            (* (reg8 *) spi_oled_IntClock__CFG0)
#define spi_oled_IntClock_DIV_LSB_PTR        ((reg8 *) spi_oled_IntClock__CFG0)
#define spi_oled_IntClock_DIV_PTR            ((reg16 *) spi_oled_IntClock__CFG0)

/* Clock MSB divider configuration register. */
#define spi_oled_IntClock_DIV_MSB            (* (reg8 *) spi_oled_IntClock__CFG1)
#define spi_oled_IntClock_DIV_MSB_PTR        ((reg8 *) spi_oled_IntClock__CFG1)

/* Mode and source configuration register */
#define spi_oled_IntClock_MOD_SRC            (* (reg8 *) spi_oled_IntClock__CFG2)
#define spi_oled_IntClock_MOD_SRC_PTR        ((reg8 *) spi_oled_IntClock__CFG2)

#if defined(spi_oled_IntClock__CFG3)
/* Analog clock phase configuration register */
#define spi_oled_IntClock_PHASE              (* (reg8 *) spi_oled_IntClock__CFG3)
#define spi_oled_IntClock_PHASE_PTR          ((reg8 *) spi_oled_IntClock__CFG3)
#endif /* defined(spi_oled_IntClock__CFG3) */


/**************************************
*       Register Constants
**************************************/

/* Power manager register masks */
#define spi_oled_IntClock_CLKEN_MASK         spi_oled_IntClock__PM_ACT_MSK
#define spi_oled_IntClock_CLKSTBY_MASK       spi_oled_IntClock__PM_STBY_MSK

/* CFG2 field masks */
#define spi_oled_IntClock_SRC_SEL_MSK        spi_oled_IntClock__CFG2_SRC_SEL_MASK
#define spi_oled_IntClock_MODE_MASK          (~(spi_oled_IntClock_SRC_SEL_MSK))

#if defined(spi_oled_IntClock__CFG3)
/* CFG3 phase mask */
#define spi_oled_IntClock_PHASE_MASK         spi_oled_IntClock__CFG3_PHASE_DLY_MASK
#endif /* defined(spi_oled_IntClock__CFG3) */

#endif /* CY_CLOCK_spi_oled_IntClock_H */


/* [] END OF FILE */
