keshavgupta21/6.115-final/PSoCCreator/Final Project/FinalEmulator.cydsn/codegentemp/HSYNC_OUT.h

/*******************************************************************************
* File Name: HSYNC_OUT.h  
* Version 2.20
*
* Description:
*  This file contains Pin function prototypes and register defines
*
* Note:
*
********************************************************************************
* Copyright 2008-2015, Cypress Semiconductor Corporation.  All rights reserved.
* You may use this file only in accordance with the license, terms, conditions, 
* disclaimers, and limitations in the end user license agreement accompanying 
* the software package with which this file was provided.
*******************************************************************************/

#if !defined(CY_PINS_HSYNC_OUT_H) /* Pins HSYNC_OUT_H */
#define CY_PINS_HSYNC_OUT_H

#include "cytypes.h"
#include "cyfitter.h"
#include "cypins.h"
#include "HSYNC_OUT_aliases.h"

/* APIs are not generated for P15[7:6] */
#if !(CY_PSOC5A &&\
	 HSYNC_OUT__PORT == 15 && ((HSYNC_OUT__MASK & 0xC0) != 0))


/***************************************
*        Function Prototypes             
***************************************/    

/**
* \addtogroup group_general
* @{
*/
void    HSYNC_OUT_Write(uint8 value);
void    HSYNC_OUT_SetDriveMode(uint8 mode);
uint8   HSYNC_OUT_ReadDataReg(void);
uint8   HSYNC_OUT_Read(void);
void    HSYNC_OUT_SetInterruptMode(uint16 position, uint16 mode);
uint8   HSYNC_OUT_ClearInterrupt(void);
/** @} general */

/***************************************
*           API Constants        
***************************************/
/**
* \addtogroup group_constants
* @{
*/
    /** \addtogroup driveMode Drive mode constants
     * \brief Constants to be passed as "mode" parameter in the HSYNC_OUT_SetDriveMode() function.
     *  @{
     */
        #define HSYNC_OUT_DM_ALG_HIZ         PIN_DM_ALG_HIZ
        #define HSYNC_OUT_DM_DIG_HIZ         PIN_DM_DIG_HIZ
        #define HSYNC_OUT_DM_RES_UP          PIN_DM_RES_UP
        #define HSYNC_OUT_DM_RES_DWN         PIN_DM_RES_DWN
        #define HSYNC_OUT_DM_OD_LO           PIN_DM_OD_LO
        #define HSYNC_OUT_DM_OD_HI           PIN_DM_OD_HI
        #define HSYNC_OUT_DM_STRONG          PIN_DM_STRONG
        #define HSYNC_OUT_DM_RES_UPDWN       PIN_DM_RES_UPDWN
    /** @} driveMode */
/** @} group_constants */
    
/* Digital Port Constants */
#define HSYNC_OUT_MASK               HSYNC_OUT__MASK
#define HSYNC_OUT_SHIFT              HSYNC_OUT__SHIFT
#define HSYNC_OUT_WIDTH              1u

/* Interrupt constants */
#if defined(HSYNC_OUT__INTSTAT)
/**
* \addtogroup group_constants
* @{
*/
    /** \addtogroup intrMode Interrupt constants
     * \brief Constants to be passed as "mode" parameter in HSYNC_OUT_SetInterruptMode() function.
     *  @{
     */
        #define HSYNC_OUT_INTR_NONE      (uint16)(0x0000u)
        #define HSYNC_OUT_INTR_RISING    (uint16)(0x0001u)
        #define HSYNC_OUT_INTR_FALLING   (uint16)(0x0002u)
        #define HSYNC_OUT_INTR_BOTH      (uint16)(0x0003u) 
    /** @} intrMode */
/** @} group_constants */

    #define HSYNC_OUT_INTR_MASK      (0x01u) 
#endif /* (HSYNC_OUT__INTSTAT) */


/***************************************
*             Registers        
***************************************/

/* Main Port Registers */
/* Pin State */
#define HSYNC_OUT_PS                     (* (reg8 *) HSYNC_OUT__PS)
/* Data Register */
#define HSYNC_OUT_DR                     (* (reg8 *) HSYNC_OUT__DR)
/* Port Number */
#define HSYNC_OUT_PRT_NUM                (* (reg8 *) HSYNC_OUT__PRT) 
/* Connect to Analog Globals */                                                  
#define HSYNC_OUT_AG                     (* (reg8 *) HSYNC_OUT__AG)                       
/* Analog MUX bux enable */
#define HSYNC_OUT_AMUX                   (* (reg8 *) HSYNC_OUT__AMUX) 
/* Bidirectional Enable */                                                        
#define HSYNC_OUT_BIE                    (* (reg8 *) HSYNC_OUT__BIE)
/* Bit-mask for Aliased Register Access */
#define HSYNC_OUT_BIT_MASK               (* (reg8 *) HSYNC_OUT__BIT_MASK)
/* Bypass Enable */
#define HSYNC_OUT_BYP                    (* (reg8 *) HSYNC_OUT__BYP)
/* Port wide control signals */                                                   
#define HSYNC_OUT_CTL                    (* (reg8 *) HSYNC_OUT__CTL)
/* Drive Modes */
#define HSYNC_OUT_DM0                    (* (reg8 *) HSYNC_OUT__DM0) 
#define HSYNC_OUT_DM1                    (* (reg8 *) HSYNC_OUT__DM1)
#define HSYNC_OUT_DM2                    (* (reg8 *) HSYNC_OUT__DM2) 
/* Input Buffer Disable Override */
#define HSYNC_OUT_INP_DIS                (* (reg8 *) HSYNC_OUT__INP_DIS)
/* LCD Common or Segment Drive */
#define HSYNC_OUT_LCD_COM_SEG            (* (reg8 *) HSYNC_OUT__LCD_COM_SEG)
/* Enable Segment LCD */
#define HSYNC_OUT_LCD_EN                 (* (reg8 *) HSYNC_OUT__LCD_EN)
/* Slew Rate Control */
#define HSYNC_OUT_SLW                    (* (reg8 *) HSYNC_OUT__SLW)

/* DSI Port Registers */
/* Global DSI Select Register */
#define HSYNC_OUT_PRTDSI__CAPS_SEL       (* (reg8 *) HSYNC_OUT__PRTDSI__CAPS_SEL) 
/* Double Sync Enable */
#define HSYNC_OUT_PRTDSI__DBL_SYNC_IN    (* (reg8 *) HSYNC_OUT__PRTDSI__DBL_SYNC_IN) 
/* Output Enable Select Drive Strength */
#define HSYNC_OUT_PRTDSI__OE_SEL0        (* (reg8 *) HSYNC_OUT__PRTDSI__OE_SEL0) 
#define HSYNC_OUT_PRTDSI__OE_SEL1        (* (reg8 *) HSYNC_OUT__PRTDSI__OE_SEL1) 
/* Port Pin Output Select Registers */
#define HSYNC_OUT_PRTDSI__OUT_SEL0       (* (reg8 *) HSYNC_OUT__PRTDSI__OUT_SEL0) 
#define HSYNC_OUT_PRTDSI__OUT_SEL1       (* (reg8 *) HSYNC_OUT__PRTDSI__OUT_SEL1) 
/* Sync Output Enable Registers */
#define HSYNC_OUT_PRTDSI__SYNC_OUT       (* (reg8 *) HSYNC_OUT__PRTDSI__SYNC_OUT) 

/* SIO registers */
#if defined(HSYNC_OUT__SIO_CFG)
    #define HSYNC_OUT_SIO_HYST_EN        (* (reg8 *) HSYNC_OUT__SIO_HYST_EN)
    #define HSYNC_OUT_SIO_REG_HIFREQ     (* (reg8 *) HSYNC_OUT__SIO_REG_HIFREQ)
    #define HSYNC_OUT_SIO_CFG            (* (reg8 *) HSYNC_OUT__SIO_CFG)
    #define HSYNC_OUT_SIO_DIFF           (* (reg8 *) HSYNC_OUT__SIO_DIFF)
#endif /* (HSYNC_OUT__SIO_CFG) */

/* Interrupt Registers */
#if defined(HSYNC_OUT__INTSTAT)
    #define HSYNC_OUT_INTSTAT            (* (reg8 *) HSYNC_OUT__INTSTAT)
    #define HSYNC_OUT_SNAP               (* (reg8 *) HSYNC_OUT__SNAP)
    
	#define HSYNC_OUT_0_INTTYPE_REG 		(* (reg8 *) HSYNC_OUT__0__INTTYPE)
#endif /* (HSYNC_OUT__INTSTAT) */

#endif /* CY_PSOC5A... */

#endif /*  CY_PINS_HSYNC_OUT_H */


/* [] END OF FILE */
