keshavgupta21/6.115-final/PSoCCreator/Final Project/FinalEmulator.cydsn/codegentemp/random_PM.c

/*******************************************************************************
* File Name: random_PM.c
* Version 2.40
*
* Description:
*  This file provides Sleep APIs for PRS component.
*
* Note:
*  None
*
********************************************************************************
* Copyright 2008-2013, Cypress Semiconductor Corporation.  All rights reserved.
* You may use this file only in accordance with the license, terms, conditions, 
* disclaimers, and limitations in the end user license agreement accompanying 
* the software package with which this file was provided.
*******************************************************************************/

#include "random.h"

#if ((random_TIME_MULTIPLEXING_ENABLE) && (random_WAKEUP_BEHAVIOUR == random__RESUMEWORK))
    uint8 random_sleepState = random_NORMAL_SEQUENCE;    
#endif  /* End ((random_TIME_MULTIPLEXING_ENABLE) && 
          (random_WAKEUP_BEHAVIOUR == random__RESUMEWORK)) */


/*******************************************************************************
* Function Name: random_SaveConfig
********************************************************************************
*
* Summary:
*  Saves seed and polynomial registers.
*
* Parameters:
*  void
*
* Return:
*  void
*
* Global Variables:
*  random_backup - modified when non-retention registers are saved.
*
*******************************************************************************/
void random_SaveConfig(void) 
{    
    #if (random_WAKEUP_BEHAVIOUR == random__RESUMEWORK)
        /* Save dff register for time mult */
        #if (random_TIME_MULTIPLEXING_ENABLE)
            random_backup.dffStatus = random_STATUS;
            /* Clear normal dff sequence set */
            random_sleepState &= ((uint8)~random_NORMAL_SEQUENCE);
        #endif  /* End random_TIME_MULTIPLEXING_ENABLE */
        
        /* Save A0 and A1 registers */
        #if (random_PRS_SIZE <= 32u)
            random_backup.seed = random_Read();
            
        #else
            random_backup.seedUpper = random_ReadUpper();
            random_backup.seedLower = random_ReadLower();
            
        #endif     /* End (random_PRS_SIZE <= 32u) */
        
    #endif  /* End (random_WAKEUP_BEHAVIOUR == random__RESUMEWORK) */
}
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
