keshavgupta21/6.115-final/(commit log)

2019-04-26 base code for emulator
    [FinalEmulator.sdf]
2019-04-29 rip ok
    [FinalEmulator.sdf]
2019-04-29 complete emulator
    [FinalEmulator.sdf]
2019-04-29 todo implement keyboard and vga
    [FinalEmulator.sdf]
2019-04-29 before vga
    [FinalEmulator.sdf]
2019-04-30 vga done
    [FinalEmulator.sdf]
2019-04-30 vga works
    [FinalEmulator.sdf]
2019-05-01 keypad working
    [FinalEmulator.sdf]
2019-05-01 Timer Debug
    [FinalEmulator.sdf]
2019-05-02 sw spi working
    [FinalEmulator.sdf]
2019-05-02 hw spi implemented
2019-05-03 todo debug oled dc
    [FinalEmulator.sdf]
2019-05-03 oled works
    [FinalEmulator.sdf]
2019-05-03 oled working
    [FinalEmulator.sdf]
2019-05-04 todo debug vga
    [FinalEmulator.sdf]
2019-05-04 keyboard deboucned
    [FinalEmulator.sdf]
2019-05-04 half working usb
    [FinalEmulator.sdf]
2019-05-06 vga back to working
    [FinalEmulator.sdf, rom.csv]
2019-05-06 programming header added
    [FinalEmulator.sdf]
2019-05-08 fix issue with call and ret
    [FinalEmulator.sdf, rom.csv]
2019-05-08 Debug CALL and RET, Add Sound, Add Case
    [FinalEmulator.sdf, box.dwg]
2019-05-09 everything done
    [FinalEmulator.sdf, rom.csv]
2019-05-16 cleaned schematic
    [FinalEmulator.sdf]
